Enchis12/HE-Keyboard-Trial/HE_Keyboard_Trial.kicad_pcb

## KiCad design HE_Keyboard_Trial.kicad_pcb (2025-02-14)

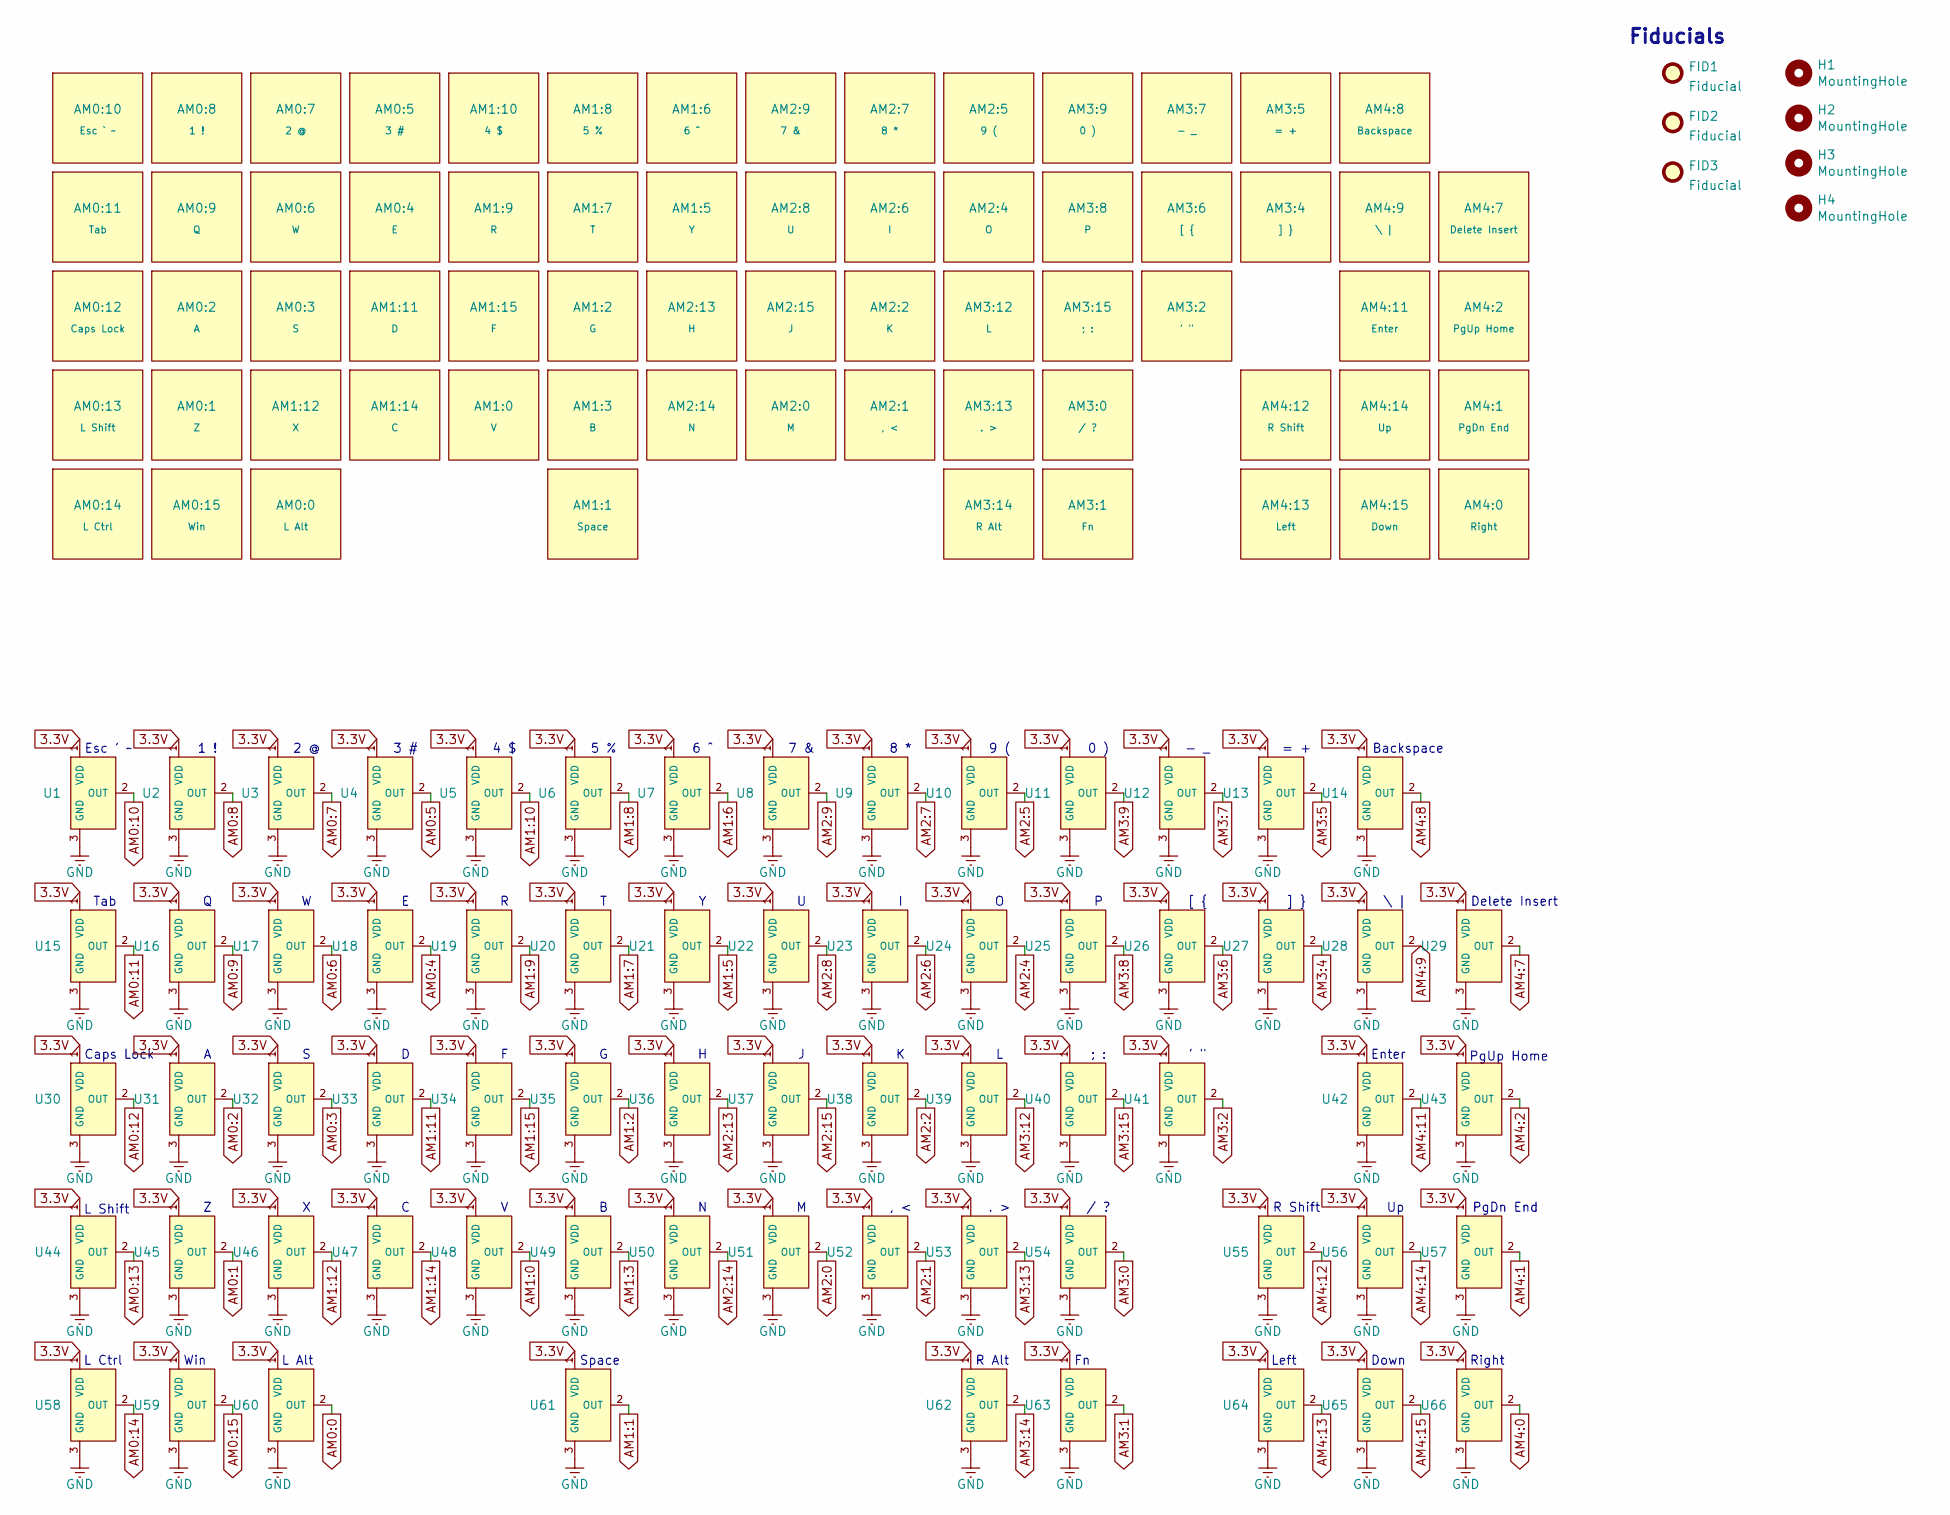
[picture p1: schematic sensor.kicad_sch, Switch, Hall Sensor, and Mounting Hole]

Parts:
AM0:0: L Alt; MX_Gateron_HE_1.25u
AM0:1: Z; MX_Gateron_HE_1u
AM0:2: A; MX_Gateron_HE_1u
AM0:3: S; MX_Gateron_HE_1u
AM0:4: E; MX_Gateron_HE_1u
AM0:5: 3 #; MX_Gateron_HE_1u
AM0:6: W; MX_Gateron_HE_1u
AM0:7: 2 @; MX_Gateron_HE_1u
AM0:8: 1 !; MX_Gateron_HE_1u
AM0:9: Q; MX_Gateron_HE_1u
AM0:10: Esc ` ~; MX_Gateron_HE_1u
AM0:11: Tab; MX_Gateron_HE_1.5u
AM0:12: Caps Lock; MX_Gateron_HE_1.75u
AM0:13: L Shift; MX_Gateron_HE_2.25u_Stab
AM0:14: L Ctrl; MX_Gateron_HE_1.25u
AM0:15: Win; MX_Gateron_HE_1.25u
AM1:0: V; MX_Gateron_HE_1u
AM1:1: Space; MX_Gateron_HE_6.25u_Stab
AM1:2: G; MX_Gateron_HE_1u
AM1:3: B; MX_Gateron_HE_1u
AM1:5: Y; MX_Gateron_HE_1u
AM1:6: 6 ^; MX_Gateron_HE_1u
AM1:7: T; MX_Gateron_HE_1u
AM1:8: 5 %; MX_Gateron_HE_1u
AM1:9: R; MX_Gateron_HE_1u
AM1:10: 4 $; MX_Gateron_HE_1u
AM1:11: D; MX_Gateron_HE_1u
AM1:12: X; MX_Gateron_HE_1u
AM1:14: C; MX_Gateron_HE_1u
AM1:15: F; MX_Gateron_HE_1u
AM2:0: M; MX_Gateron_HE_1u
AM2:1: , <; MX_Gateron_HE_1u
AM2:2: K; MX_Gateron_HE_1u
AM2:4: O; MX_Gateron_HE_1u
AM2:5: 9 (; MX_Gateron_HE_1u
AM2:6: I; MX_Gateron_HE_1u
AM2:7: 8 *; MX_Gateron_HE_1u
AM2:8: U; MX_Gateron_HE_1u
AM2:9: 7 &; MX_Gateron_HE_1u
AM2:13: H; MX_Gateron_HE_1u
AM2:14: N; MX_Gateron_HE_1u
AM2:15: J; MX_Gateron_HE_1u
AM3:0: / ?; MX_Gateron_HE_1u
AM3:1: Fn; MX_Gateron_HE_1.25u
AM3:2: ' "; MX_Gateron_HE_1u
AM3:4: ] }; MX_Gateron_HE_1u
AM3:5: = +; MX_Gateron_HE_1u
AM3:6: [ {; MX_Gateron_HE_1u
AM3:7: - _; MX_Gateron_HE_1u
AM3:8: P; MX_Gateron_HE_1u
AM3:9: 0 ); MX_Gateron_HE_1u
AM3:12: L; MX_Gateron_HE_1u
AM3:13: . >; MX_Gateron_HE_1u
AM3:14: R Alt; MX_Gateron_HE_1.25u
AM3:15: ; :; MX_Gateron_HE_1u
AM4:0: Right; MX_Gateron_HE_1u
AM4:1: PgDn End; MX_Gateron_HE_1u
AM4:2: PgUp Home; MX_Gateron_HE_1u
AM4:7: Delete Insert; MX_Gateron_HE_1u
AM4:8: Backspace; MX_Gateron_HE_2u_Stab
AM4:9: \ |; MX_Gateron_HE_1.5u
AM4:11: Enter; MX_Gateron_HE_2.25u_Stab
AM4:12: R Shift; MX_Gateron_HE_1.75u
AM4:13: Left; MX_Gateron_HE_1u
AM4:14: Up; MX_Gateron_HE_1u
AM4:15: Down; MX_Gateron_HE_1u
FID1, FID2, FID3: Fiducial; Fiducial_1mm_Mask2mm
H1, H2, H3, H4: MountingHole; MountingHole_2.2mm_M2
U1, U2, U3, U4, U5, U6, U7, U8, U9, U10, U11, U12, U13, U14, U15, U16, U17, U18, U19, U20, U21, U22, U23, U24, U25, U26, U27, U28, U29, U30, U31, U32, U33, U34, U35, U36, U37, U38, U39, U40, U41, U42, U43, U44, U45, U46, U47, U48, U49, U50, U51, U52, U53, U54, U55, U56, U57, U58, U59, U60, U61, U62, U63, U64, U65, U66: Hall_Sensor; GH39FKSW_OH49E-S; MPN GH39FKSW; LCSC Part C266230

Connections:
3.3V: U1.1 (VDD), U2.1 (VDD), U3.1 (VDD), U4.1 (VDD), U5.1 (VDD), U6.1 (VDD), U7.1 (VDD), U8.1 (VDD), U9.1 (VDD), U10.1 (VDD), U11.1 (VDD), U12.1 (VDD), U13.1 (VDD), U14.1 (VDD), U15.1 (VDD), U16.1 (VDD), U17.1 (VDD), U18.1 (VDD), U19.1 (VDD), U20.1 (VDD), U21.1 (VDD), U22.1 (VDD), U23.1 (VDD), U24.1 (VDD), U25.1 (VDD), U26.1 (VDD), U27.1 (VDD), U28.1 (VDD), U29.1 (VDD), U30.1 (VDD), U31.1 (VDD), U32.1 (VDD), U33.1 (VDD), U34.1 (VDD), U35.1 (VDD), U36.1 (VDD), U37.1 (VDD), U38.1 (VDD), U39.1 (VDD), U40.1 (VDD), U41.1 (VDD), U42.1 (VDD), U43.1 (VDD), U44.1 (VDD), U45.1 (VDD), U46.1 (VDD), U47.1 (VDD), U48.1 (VDD), U49.1 (VDD), U50.1 (VDD), U51.1 (VDD), U52.1 (VDD), U53.1 (VDD), U54.1 (VDD), U55.1 (VDD), U56.1 (VDD), U57.1 (VDD), U58.1 (VDD), U59.1 (VDD), U60.1 (VDD), U61.1 (VDD), U62.1 (VDD), U63.1 (VDD), U64.1 (VDD), U65.1 (VDD), U66.1 (VDD); also elsewhere on the board
AM0:0: U60.2 (OUT); also elsewhere on the board
AM0:1: U45.2 (OUT); also elsewhere on the board
AM0:2: U31.2 (OUT); also elsewhere on the board
AM0:3: U32.2 (OUT); also elsewhere on the board
AM0:4: U18.2 (OUT); also elsewhere on the board
AM0:5: U4.2 (OUT); also elsewhere on the board
AM0:6: U17.2 (OUT); also elsewhere on the board
AM0:7: U3.2 (OUT); also elsewhere on the board
AM0:8: U2.2 (OUT); also elsewhere on the board
AM0:9: U16.2 (OUT); also elsewhere on the board
AM0:10: U1.2 (OUT); also elsewhere on the board
AM0:11: U15.2 (OUT); also elsewhere on the board
AM0:12: U30.2 (OUT); also elsewhere on the board
AM0:13: U44.2 (OUT); also elsewhere on the board
AM0:14: U58.2 (OUT); also elsewhere on the board
AM0:15: U59.2 (OUT); also elsewhere on the board
AM1:0: U48.2 (OUT); also elsewhere on the board
AM1:1: U61.2 (OUT); also elsewhere on the board
AM1:2: U35.2 (OUT); also elsewhere on the board
AM1:3: U49.2 (OUT); also elsewhere on the board
AM1:5: U21.2 (OUT); also elsewhere on the board
AM1:6: U7.2 (OUT); also elsewhere on the board
AM1:7: U20.2 (OUT); also elsewhere on the board
AM1:8: U6.2 (OUT); also elsewhere on the board
AM1:9: U19.2 (OUT); also elsewhere on the board
AM1:10: U5.2 (OUT); also elsewhere on the board
AM1:11: U33.2 (OUT); also elsewhere on the board
AM1:12: U46.2 (OUT); also elsewhere on the board
AM1:14: U47.2 (OUT); also elsewhere on the board
AM1:15: U34.2 (OUT); also elsewhere on the board
AM2:0: U51.2 (OUT); also elsewhere on the board
AM2:1: U52.2 (OUT); also elsewhere on the board
AM2:2: U38.2 (OUT); also elsewhere on the board
AM2:4: U24.2 (OUT); also elsewhere on the board
AM2:5: U10.2 (OUT); also elsewhere on the board
AM2:6: U23.2 (OUT); also elsewhere on the board
AM2:7: U9.2 (OUT); also elsewhere on the board
AM2:8: U22.2 (OUT); also elsewhere on the board
AM2:9: U8.2 (OUT); also elsewhere on the board
AM2:13: U36.2 (OUT); also elsewhere on the board
AM2:14: U50.2 (OUT); also elsewhere on the board
AM2:15: U37.2 (OUT); also elsewhere on the board
AM3:0: U54.2 (OUT); also elsewhere on the board
AM3:1: U63.2 (OUT); also elsewhere on the board
AM3:2: U41.2 (OUT); also elsewhere on the board
AM3:4: U27.2 (OUT); also elsewhere on the board
AM3:5: U13.2 (OUT); also elsewhere on the board
AM3:6: U26.2 (OUT); also elsewhere on the board
AM3:7: U12.2 (OUT); also elsewhere on the board
AM3:8: U25.2 (OUT); also elsewhere on the board
AM3:9: U11.2 (OUT); also elsewhere on the board
AM3:12: U39.2 (OUT); also elsewhere on the board
AM3:13: U53.2 (OUT); also elsewhere on the board
AM3:14: U62.2 (OUT); also elsewhere on the board
AM3:15: U40.2 (OUT); also elsewhere on the board
AM4:0: U66.2 (OUT); also elsewhere on the board
AM4:1: U57.2 (OUT); also elsewhere on the board
AM4:2: U43.2 (OUT); also elsewhere on the board
AM4:7: U29.2 (OUT); also elsewhere on the board
AM4:8: U14.2 (OUT); also elsewhere on the board
AM4:9: U28.2 (OUT); also elsewhere on the board
AM4:11: U42.2 (OUT); also elsewhere on the board
AM4:12: U55.2 (OUT); also elsewhere on the board
AM4:13: U64.2 (OUT); also elsewhere on the board
AM4:14: U56.2 (OUT); also elsewhere on the board
AM4:15: U65.2 (OUT); also elsewhere on the board
GND: U1.3 (GND), U2.3 (GND), U3.3 (GND), U4.3 (GND), U5.3 (GND), U6.3 (GND), U7.3 (GND), U8.3 (GND), U9.3 (GND), U10.3 (GND), U11.3 (GND), U12.3 (GND), U13.3 (GND), U14.3 (GND), U15.3 (GND), U16.3 (GND), U17.3 (GND), U18.3 (GND), U19.3 (GND), U20.3 (GND), U21.3 (GND), U22.3 (GND), U23.3 (GND), U24.3 (GND), U25.3 (GND), U26.3 (GND), U27.3 (GND), U28.3 (GND), U29.3 (GND), U30.3 (GND), U31.3 (GND), U32.3 (GND), U33.3 (GND), U34.3 (GND), U35.3 (GND), U36.3 (GND), U37.3 (GND), U38.3 (GND), U39.3 (GND), U40.3 (GND), U41.3 (GND), U42.3 (GND), U43.3 (GND), U44.3 (GND), U45.3 (GND), U46.3 (GND), U47.3 (GND), U48.3 (GND), U49.3 (GND), U50.3 (GND), U51.3 (GND), U52.3 (GND), U53.3 (GND), U54.3 (GND), U55.3 (GND), U56.3 (GND), U57.3 (GND), U58.3 (GND), U59.3 (GND), U60.3 (GND), U61.3 (GND), U62.3 (GND), U63.3 (GND), U64.3 (GND), U65.3 (GND), U66.3 (GND); also elsewhere on the board

Notes on the sheet:
Fiducials
Delete Insert
PgUp Home
] }
Space
. >
Backspace
PgDn End
, <
Win
Left
5 %
Enter
\ |
4 $
Down
3 #
Right
R Shift
= +
Tab
7 &
Caps Lock
2 @
L Alt
Esc ' ~
R Alt
; :
0 )
- _
9 (
1 !
/ ?
[ {
' "
6 ^
L Ctrl
8 *
L Shift
