Enchis12/HE-Keyboard-Trial/HE_Keyboard_Trial.kicad_pcb

## KiCad design HE_Keyboard_Trial.kicad_pcb (continued)

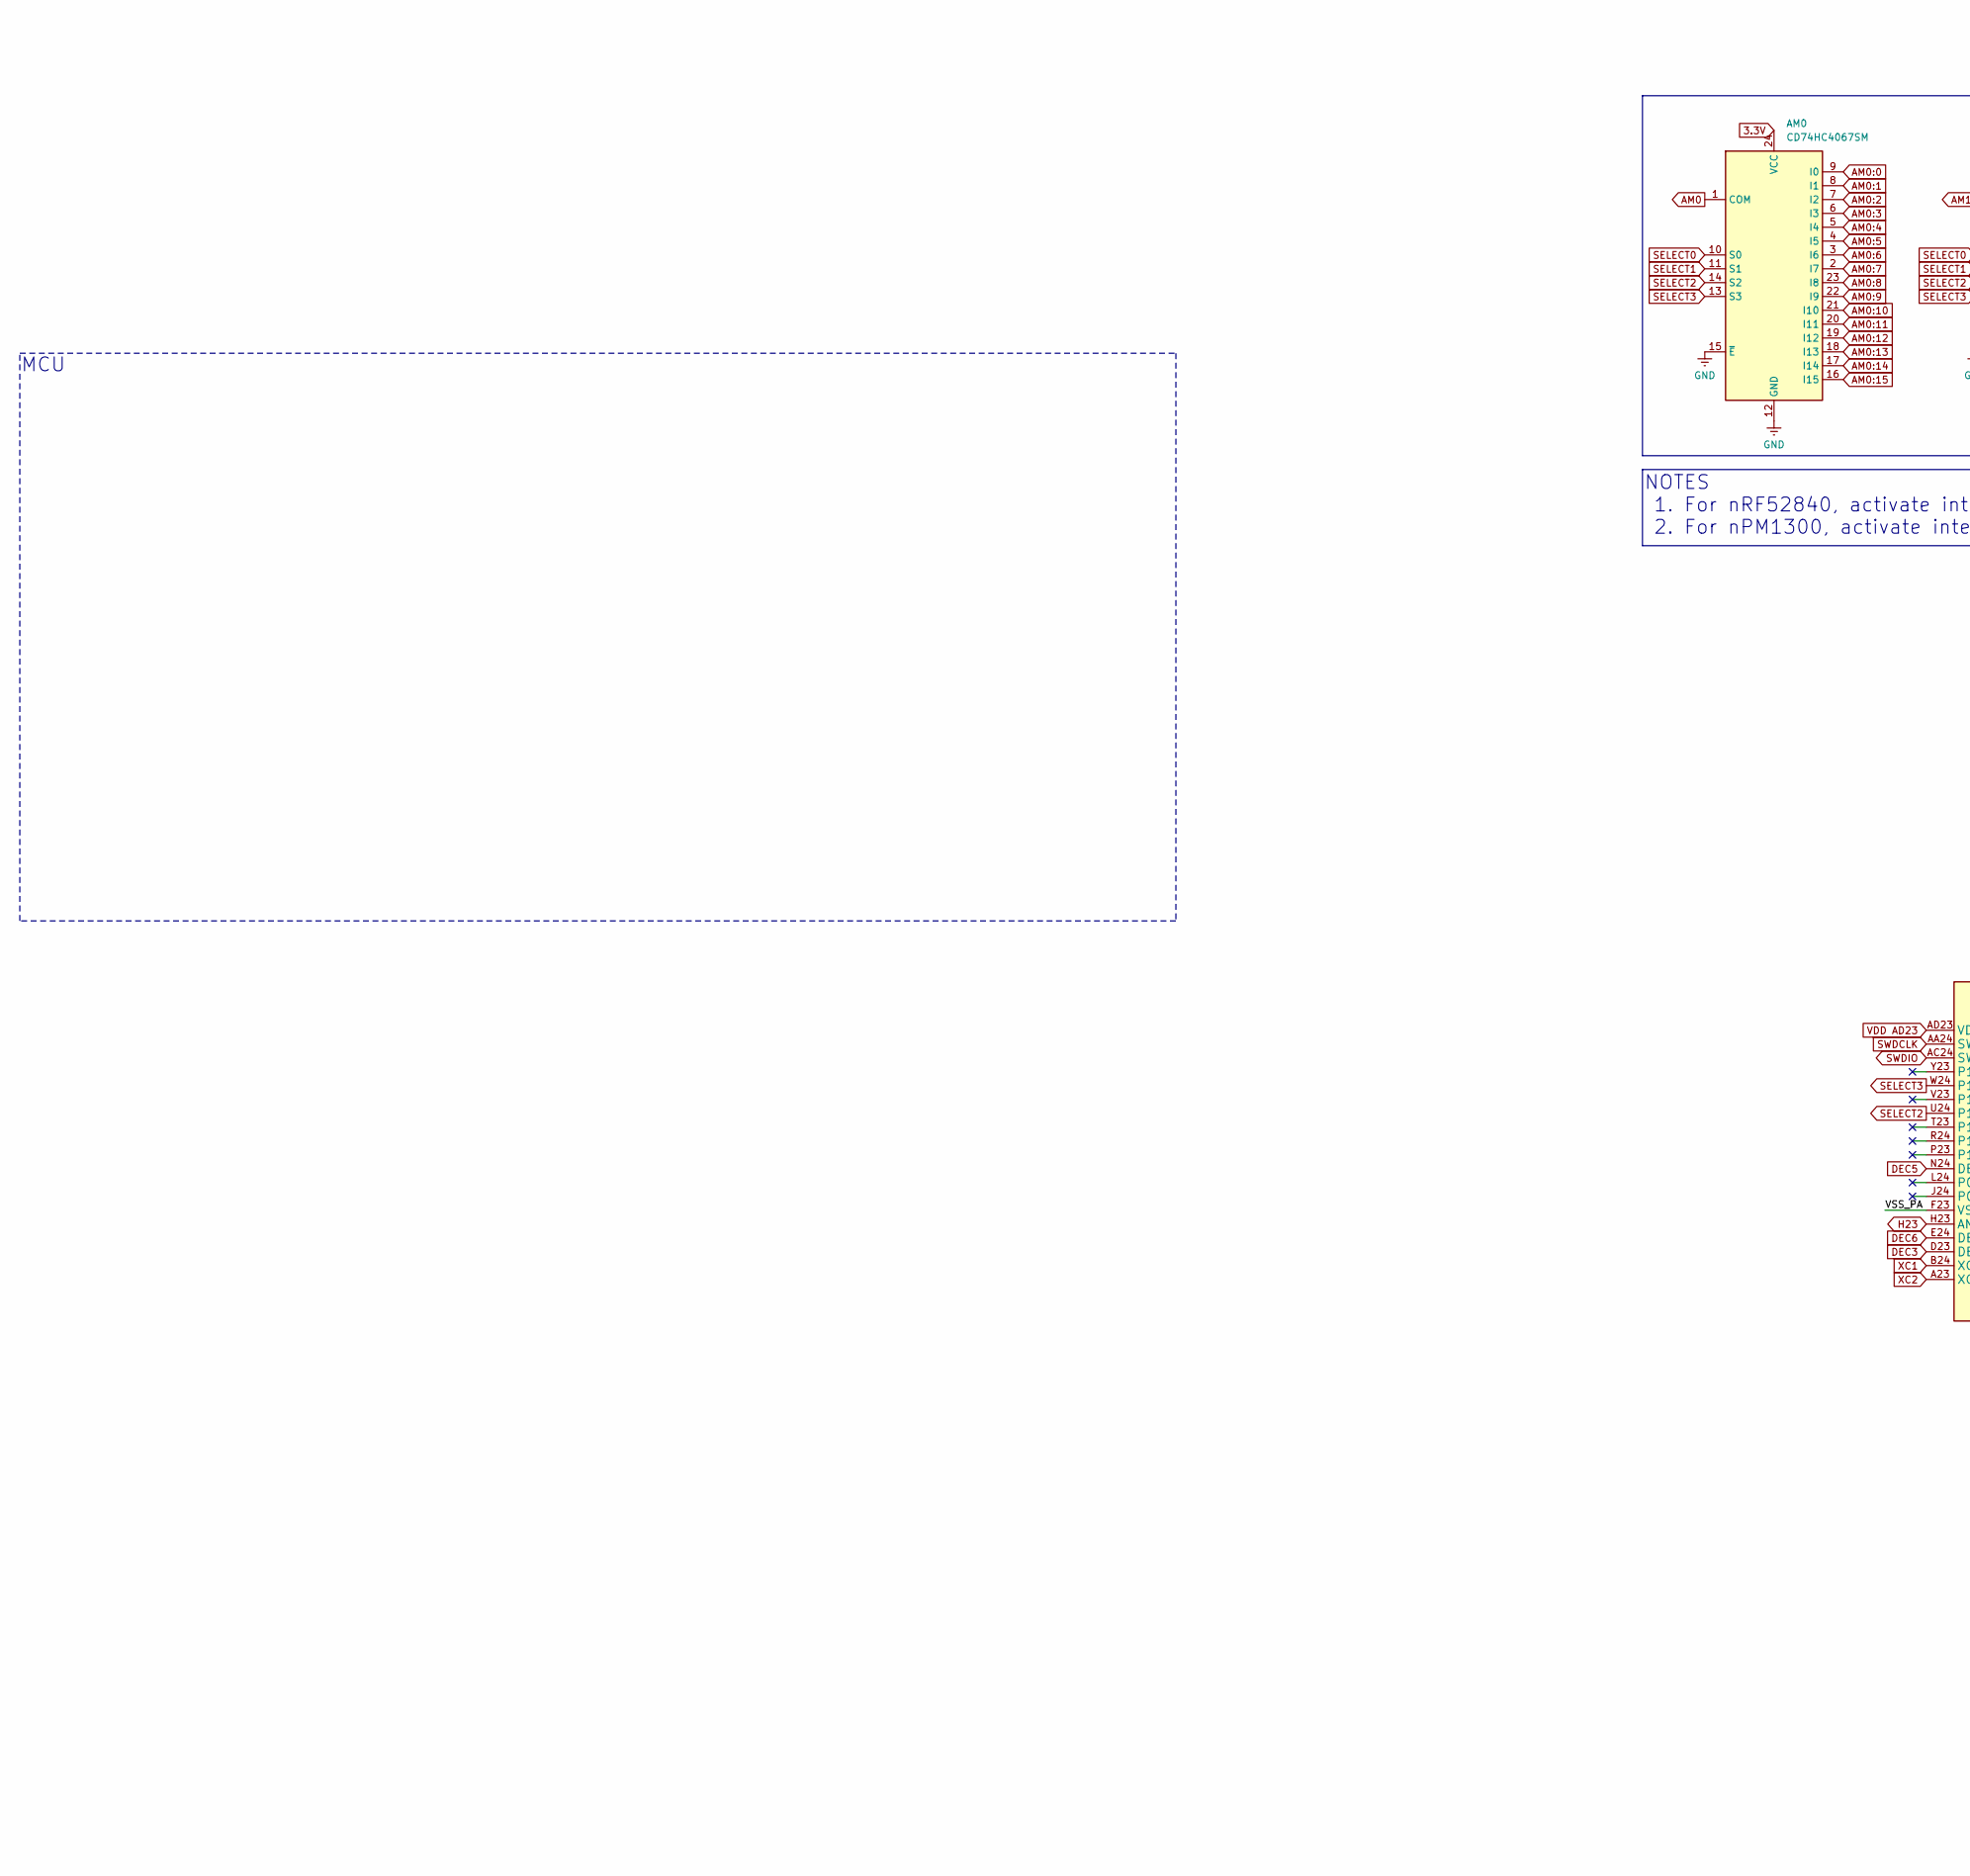
[picture p2: schematic MB.kicad_sch, Mainboard, part in row 1, column 1]

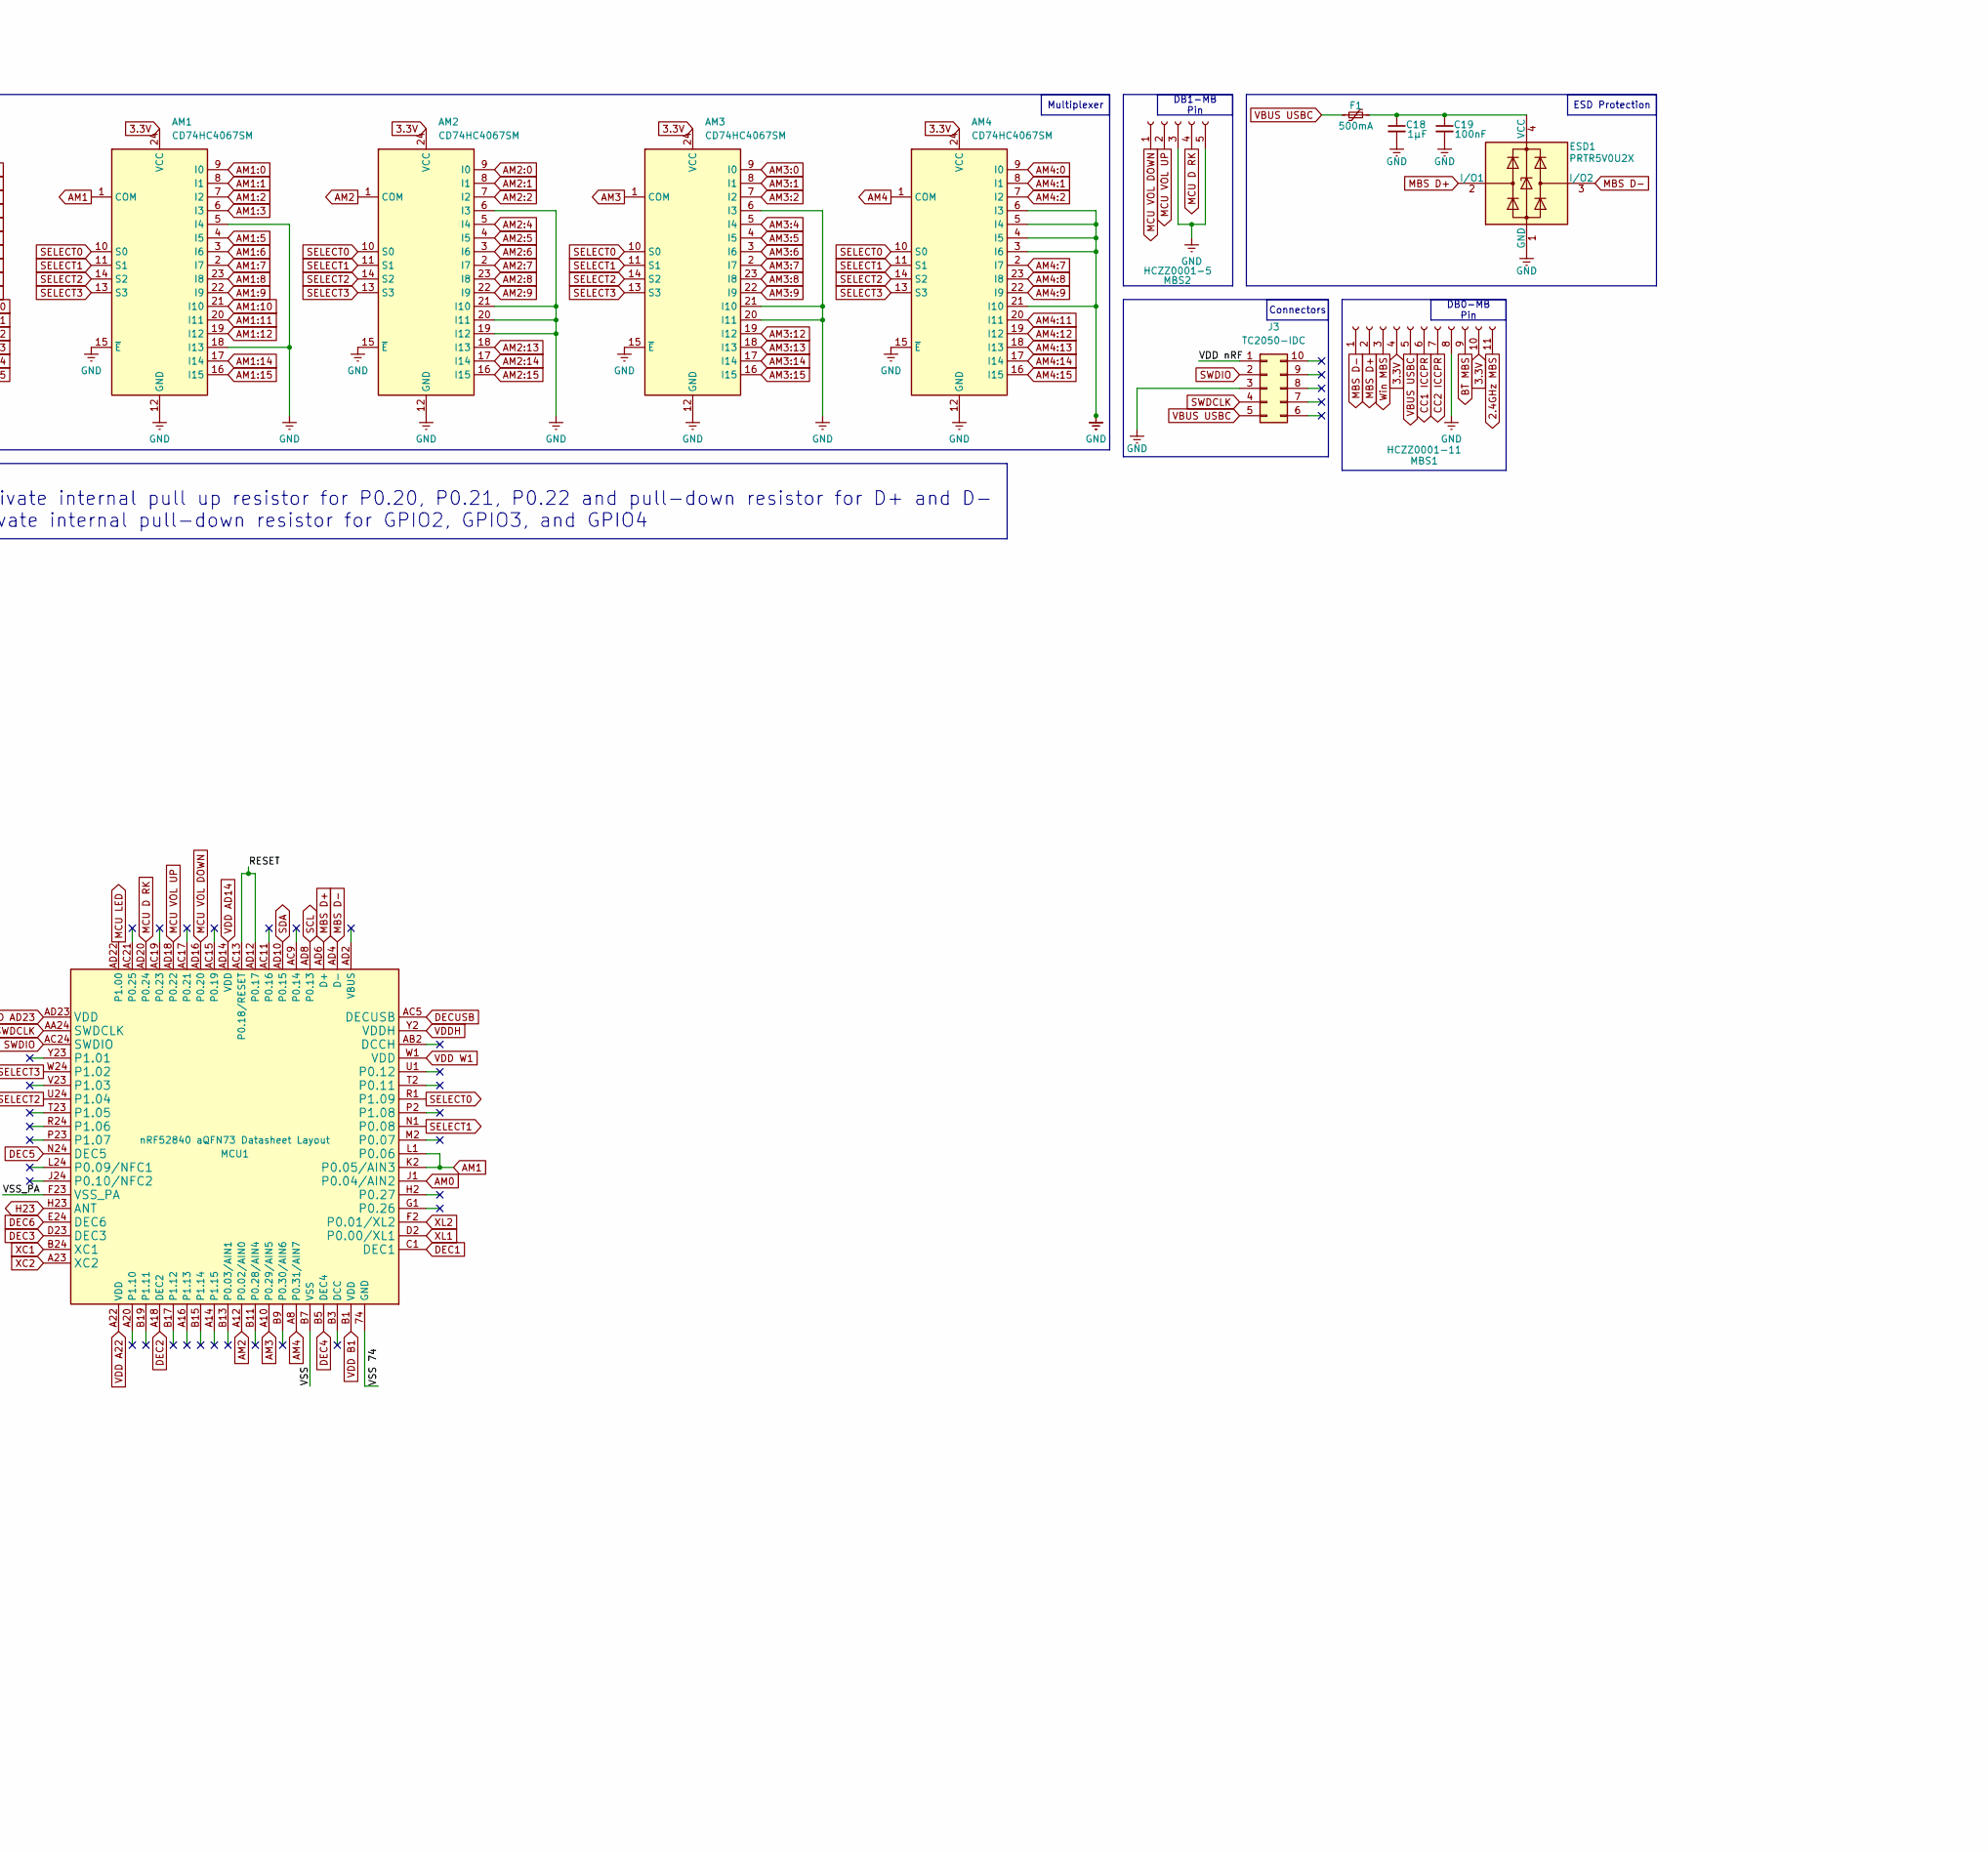
[picture p3: schematic MB.kicad_sch, Mainboard, part in row 1, column 2]

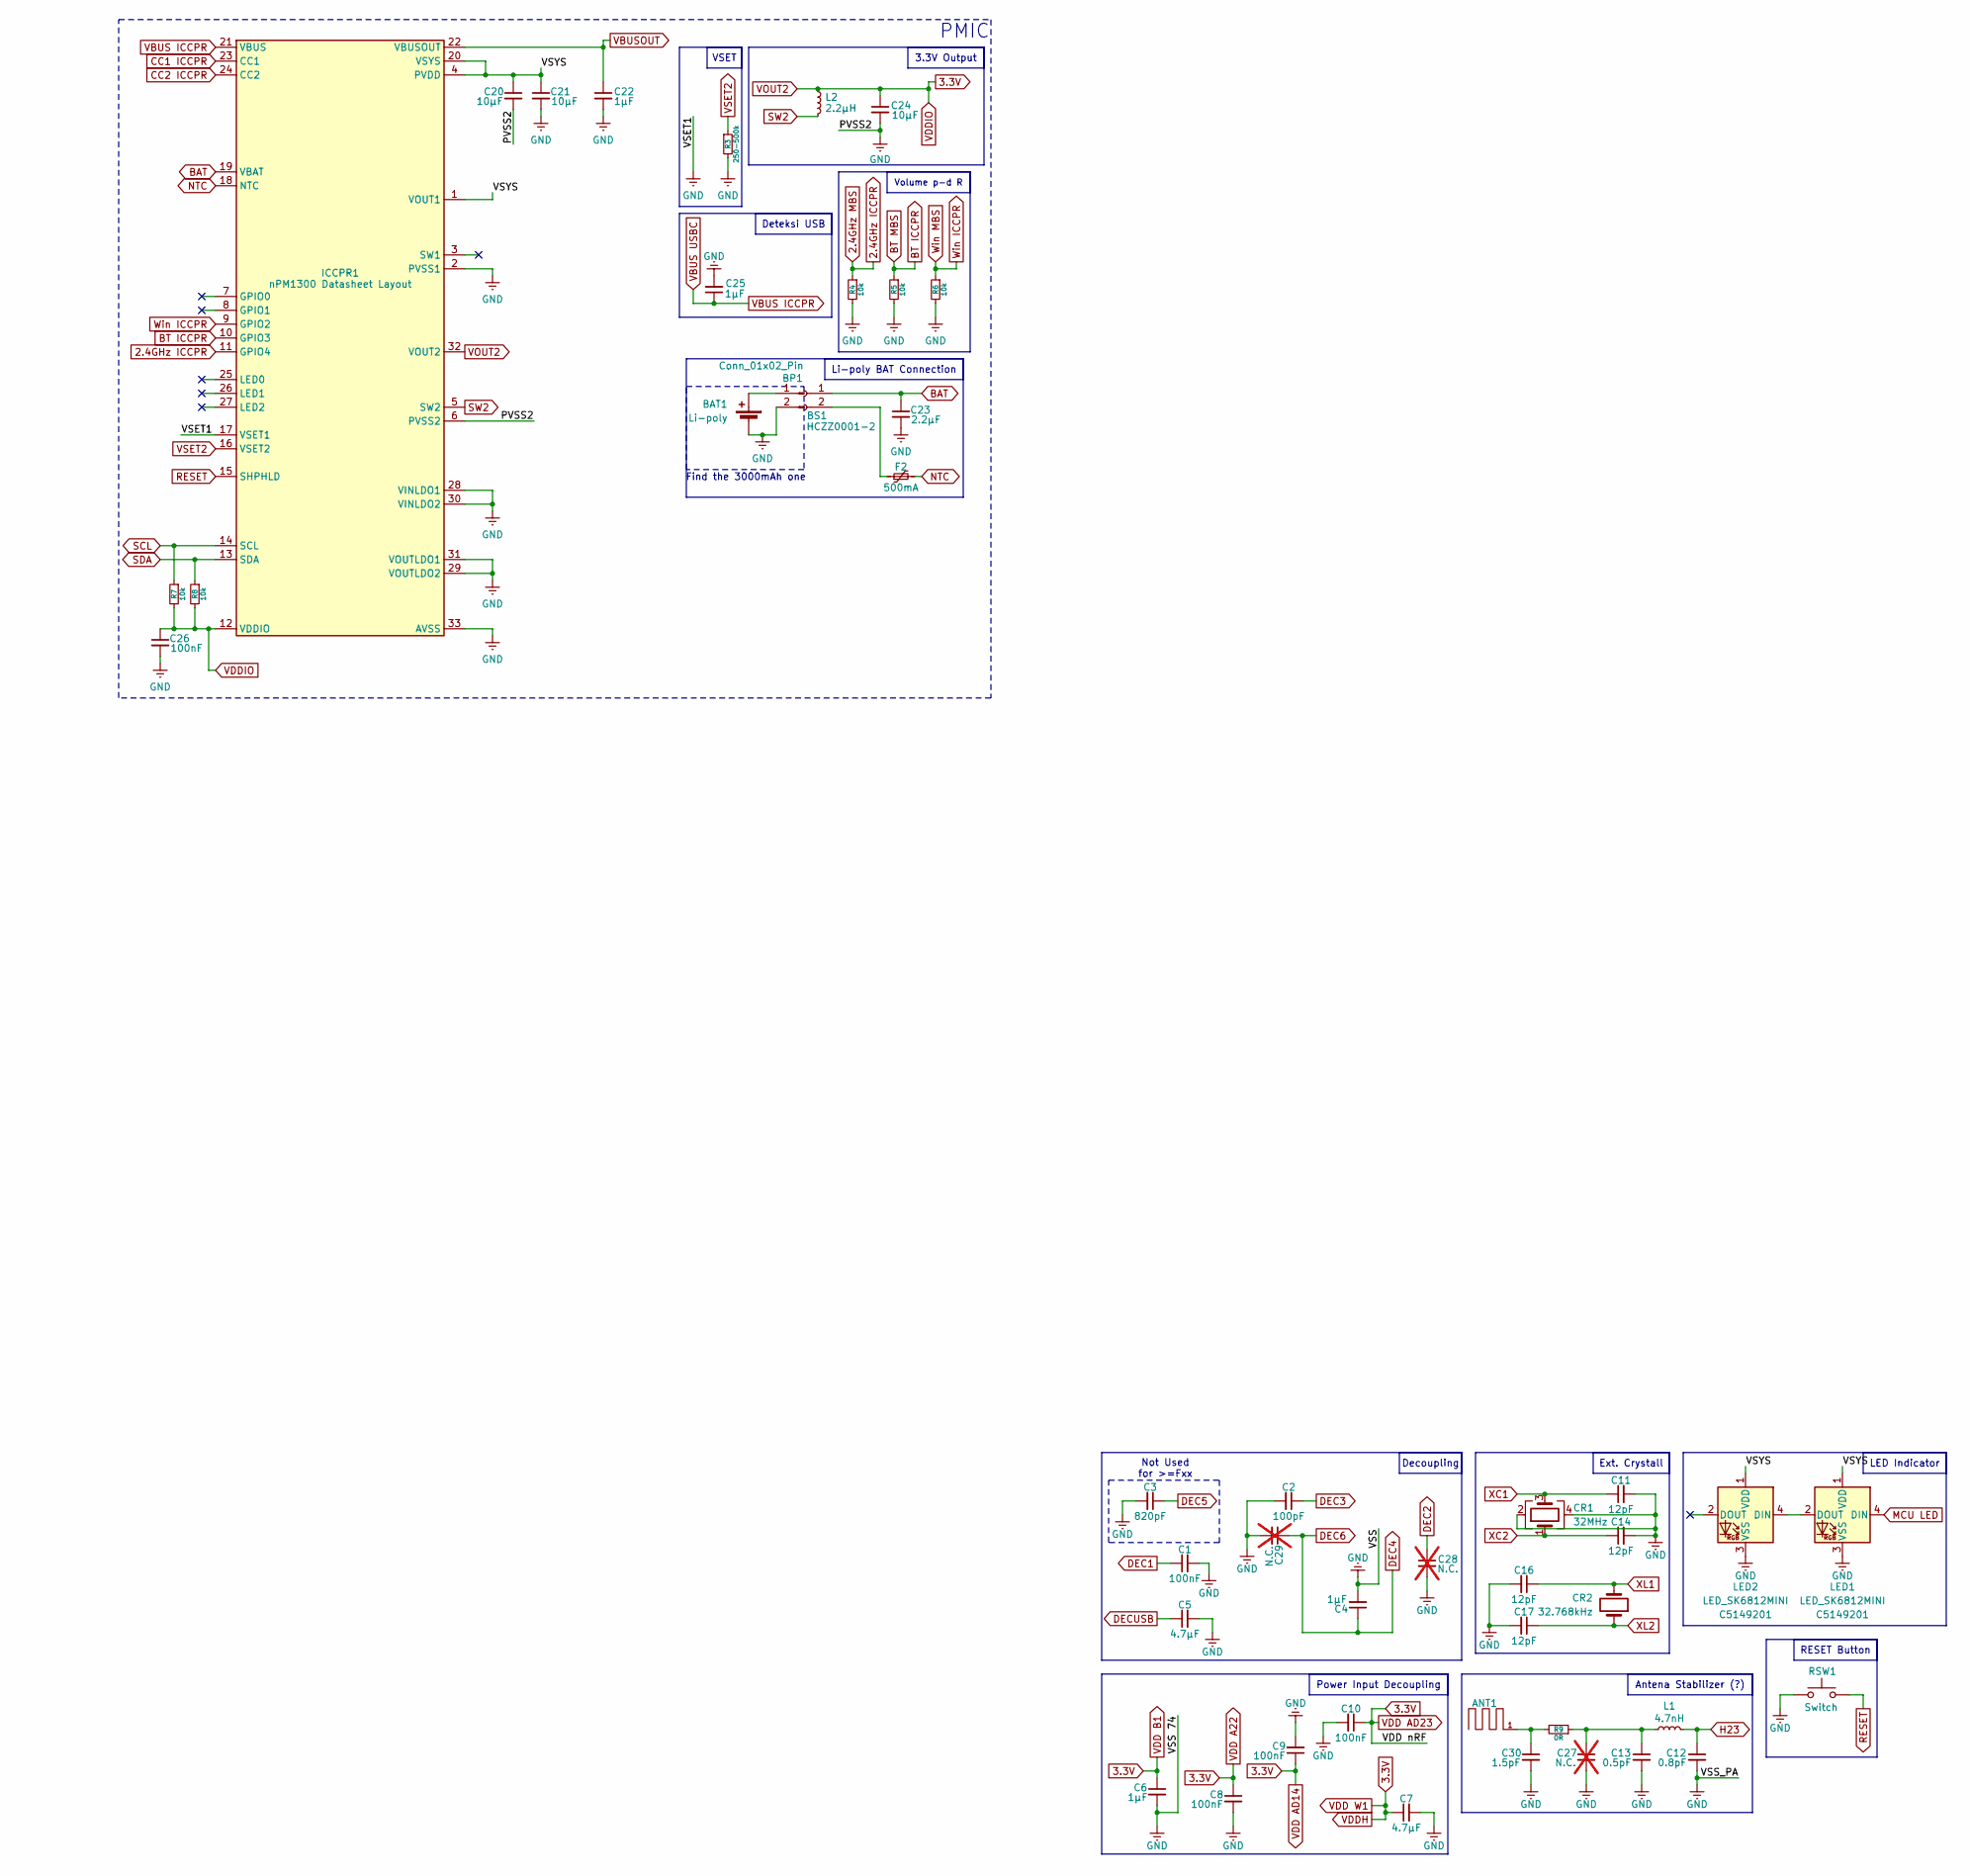
[picture p4: schematic MB.kicad_sch, Mainboard, part in row 1, column 3]

Parts:
AM0, AM1, AM2, AM3, AM4: CD74HC4067SM; SSOP-24_5.3x8.2mm_P0.65mm; LCSC Part C98457
ANT1: MIFA
BAT1: Li-poly
BP1: Conn_01x02_Pin
BS1: HCZZ0001-2; Hong_Cheng_HCZZ0001-2; LCSC Part C7433453
C1, C8, C9, C10, C19: 100nF; Capacitor_0402
C2: 100pF; Capacitor_0402
C3: 820pF; Capacitor_0402
C4, C6, C22, C25: 1µF; Capacitor_0603
C5, C7: 4.7µF; Capacitor_0603
C11, C14, C16, C17: 12pF; Capacitor_0402
C12: 0.8pF; Capacitor_0402
C13: 0.5pF; Capacitor_0402
C18: 1µF; Capacitor_0402
C20, C21, C24: 10µF; Capacitor_0603
C23: 2.2µF; Capacitor_0603
C26: 100nF; C_0201_0603Metric
C27, C28, C29: N.C.; Capacitor_0402; not fitted
C30: 1.5pF; Capacitor_0402
CR1: 32MHz; Murata_Crystal_SMD_2016-4Pin_2.0x1.6mm; LCSC Part C914155
CR2: 32.768kHz; Crystal_SMD_3215-2Pin_3.2x1.5mm; LCSC Part C97605
ESD1: PRTR5V0U2X; SOT-143; LCSC Part C41409257
F1, F2: 500mA; Fuse_1206_3216Metric; LCSC Part C269112
ICCPR1: nPM1300 Datasheet Layout; Nordic_QFN-32-1EP_5x5mm_P0.5mm_EP3.6x3.6mm_ThermalVias; LCSC Part C7501206
J3: TC2050-IDC; Tag-Connect_TC2050-IDC-NL_2x05_P1.27mm_Vertical
L1: 4.7nH; L_0402_1005Metric; LCSC Part C3249625
L2: 2.2µH; Samsung_CIGT201610EH2R2MNE; LCSC Part C5185544
LED1, LED2: LED_SK6812MINI; LCSC C5149201
MBS1: HCZZ0001-11; Hong_Cheng_HCZZ0001-11; LCSC Part C7433462
MBS2: HCZZ0001-5; Hong_Cheng_HCZZ0001-5; LCSC Part C7433456
MCU1: nRF52840 aQFN73 Datasheet Layout; Nordic_AQFN-73-1EP_7x7mm_P0.5mm_Thermal
R3: 250-500k; R_0201_0603Metric
R4, R5, R6, R7, R8: 10k; R_0201_0603Metric
R9: 0R; R_0201_0603Metric
RSW1: Switch; Button_TL3342; LCSC Part C2886897

Connections:
2.4GHz ICCPR: ICCPR1.11 (GPIO4), MBS1.11, R4.1
3.3V: AM0.24 (VCC), AM1.24 (VCC), AM2.24 (VCC), AM3.24 (VCC), AM4.24 (VCC), C6.1, C7.1, C8.1, C9.1, C10.1, C24.1, C26.1, ICCPR1.12 (VDDIO), ICCPR1.32 (VOUT2), J3.1, L2.1, MBS1.4, MBS1.10, MCU1.A22 (VDD), MCU1.AD14 (VDD), MCU1.AD23 (VDD), MCU1.B1 (VDD), MCU1.W1 (VDD), MCU1.Y2 (VDDH), R7.2, R8.2; also elsewhere on the board
/Main Board/VSYS: C20.1, C21.1, ICCPR1.1 (VOUT1), ICCPR1.4 (PVDD), ICCPR1.20 (VSYS), LED1.1 (VDD), LED2.1 (VDD)
AM0: AM0.1 (COM), MCU1.J1 (P0.04/AIN2)
AM0:0: AM0.9 (I0); also elsewhere on the board
AM0:1: AM0.8 (I1); also elsewhere on the board
AM0:2: AM0.7 (I2); also elsewhere on the board
AM0:3: AM0.6 (I3); also elsewhere on the board
AM0:4: AM0.5 (I4); also elsewhere on the board
AM0:5: AM0.4 (I5); also elsewhere on the board
AM0:6: AM0.3 (I6); also elsewhere on the board
AM0:7: AM0.2 (I7); also elsewhere on the board
AM0:8: AM0.23 (I8); also elsewhere on the board
AM0:9: AM0.22 (I9); also elsewhere on the board
AM0:10: AM0.21 (I10); also elsewhere on the board
AM0:11: AM0.20 (I11); also elsewhere on the board
AM0:12: AM0.19 (I12); also elsewhere on the board
AM0:13: AM0.18 (I13); also elsewhere on the board
AM0:14: AM0.17 (I14); also elsewhere on the board
AM0:15: AM0.16 (I15); also elsewhere on the board
AM1: AM1.1 (COM), MCU1.K2 (P0.05/AIN3), MCU1.L1 (P0.06)
AM1:0: AM1.9 (I0); also elsewhere on the board
AM1:1: AM1.8 (I1); also elsewhere on the board
AM1:2: AM1.7 (I2); also elsewhere on the board
AM1:3: AM1.6 (I3); also elsewhere on the board
AM1:5: AM1.4 (I5); also elsewhere on the board
AM1:6: AM1.3 (I6); also elsewhere on the board
AM1:7: AM1.2 (I7); also elsewhere on the board
AM1:8: AM1.23 (I8); also elsewhere on the board
AM1:9: AM1.22 (I9); also elsewhere on the board
AM1:10: AM1.21 (I10); also elsewhere on the board
AM1:11: AM1.20 (I11); also elsewhere on the board
AM1:12: AM1.19 (I12); also elsewhere on the board
AM1:14: AM1.17 (I14); also elsewhere on the board
AM1:15: AM1.16 (I15); also elsewhere on the board
AM2: AM2.1 (COM), MCU1.A12 (P0.02/AIN0)
AM2:0: AM2.9 (I0); also elsewhere on the board
AM2:1: AM2.8 (I1); also elsewhere on the board
AM2:2: AM2.7 (I2); also elsewhere on the board
AM2:4: AM2.5 (I4); also elsewhere on the board
AM2:5: AM2.4 (I5); also elsewhere on the board
AM2:6: AM2.3 (I6); also elsewhere on the board
AM2:7: AM2.2 (I7); also elsewhere on the board
AM2:8: AM2.23 (I8); also elsewhere on the board
AM2:9: AM2.22 (I9); also elsewhere on the board
AM2:13: AM2.18 (I13); also elsewhere on the board
AM2:14: AM2.17 (I14); also elsewhere on the board
AM2:15: AM2.16 (I15); also elsewhere on the board
AM3: AM3.1 (COM), MCU1.A10 (P0.29/AIN5)
AM3:0: AM3.9 (I0); also elsewhere on the board
AM3:1: AM3.8 (I1); also elsewhere on the board
AM3:2: AM3.7 (I2); also elsewhere on the board
AM3:4: AM3.5 (I4); also elsewhere on the board
AM3:5: AM3.4 (I5); also elsewhere on the board
AM3:6: AM3.3 (I6); also elsewhere on the board
AM3:7: AM3.2 (I7); also elsewhere on the board
AM3:8: AM3.23 (I8); also elsewhere on the board
AM3:9: AM3.22 (I9); also elsewhere on the board
AM3:12: AM3.19 (I12); also elsewhere on the board
AM3:13: AM3.18 (I13); also elsewhere on the board
AM3:14: AM3.17 (I14); also elsewhere on the board
AM3:15: AM3.16 (I15); also elsewhere on the board
AM4: AM4.1 (COM), MCU1.A8 (P0.31/AIN7)
AM4:0: AM4.9 (I0); also elsewhere on the board
AM4:1: AM4.8 (I1); also elsewhere on the board
AM4:2: AM4.7 (I2); also elsewhere on the board
AM4:7: AM4.2 (I7); also elsewhere on the board
AM4:8: AM4.23 (I8); also elsewhere on the board
AM4:9: AM4.22 (I9); also elsewhere on the board
AM4:11: AM4.20 (I11); also elsewhere on the board
AM4:12: AM4.19 (I12); also elsewhere on the board
AM4:13: AM4.18 (I13); also elsewhere on the board
AM4:14: AM4.17 (I14); also elsewhere on the board
AM4:15: AM4.16 (I15); also elsewhere on the board
BAT: BS1.1, C23.1, ICCPR1.19 (VBAT)
BT ICCPR: ICCPR1.10 (GPIO3), MBS1.9, R5.1
CC1 ICCPR: ICCPR1.23 (CC1), MBS1.6
CC2 ICCPR: ICCPR1.24 (CC2), MBS1.7
DEC1: C1.1, MCU1.C1 (DEC1)
DEC2: C28.1, MCU1.A18 (DEC2)
DEC3: C2.1, MCU1.D23 (DEC3)
DEC4: C4.1, C29.1, MCU1.B5 (DEC4), MCU1.E24 (DEC6)
DEC5: C3.1, MCU1.N24 (DEC5)
DECUSB: C5.1, MCU1.AC5 (DECUSB)
GND: AM0.12 (GND), AM0.15 (~E), AM1.5 (I4), AM1.12 (GND), AM1.15 (~E), AM1.18 (I13), AM2.6 (I3), AM2.12 (GND), AM2.15 (~E), AM2.19 (I12), AM2.20 (I11), AM2.21 (I10), AM3.6 (I3), AM3.12 (GND), AM3.15 (~E), AM3.20 (I11), AM3.21 (I10), AM4.3 (I6), AM4.4 (I5), AM4.5 (I4), AM4.6 (I3), AM4.12 (GND), AM4.15 (~E), AM4.21 (I10), BAT1.2 (-), BP1.2, C1.2, C2.2, C3.2, C4.2, C5.2, C6.2, C7.2, C8.2, C9.2, C10.2, C11.2, C12.2, C13.2, C14.2, C16.2, C17.2, C18.2, C19.2, C20.2, C21.2, C22.2, C23.2, C24.2, C25.2, C26.2, C27.2, C28.2, C29.2, C30.2, CR1.2, CR1.4, ESD1.1 (GND), ICCPR1.2 (PVSS1), ICCPR1.6 (PVSS2), ICCPR1.17 (VSET1), ICCPR1.28 (VINLDO1), ICCPR1.29 (VOUTLDO2), ICCPR1.30 (VINLDO2), ICCPR1.31 (VOUTLDO1), ICCPR1.33 (AVSS), J3.3, LED1.3 (VSS), LED2.3 (VSS), MBS1.8, MBS2.3, MBS2.5, MCU1.74 (GND), MCU1.B7 (VSS), MCU1.F23 (VSS_PA), R3.2, R4.2, R5.2, R6.2, RSW1.1; also elsewhere on the board
H23: C12.1, L1.1, MCU1.H23 (ANT)
MBS D+: ESD1.2 (I/O1), MBS1.2, MCU1.AD6 (D+)
MBS D-: ESD1.3 (I/O2), MBS1.1, MCU1.AD4 (D-)
MCU D RK: MBS2.4, MCU1.AD20 (P0.24)
MCU LED: LED1.4 (DIN), MCU1.AD22 (P1.00)
MCU VOL DOWN: MBS2.1, MCU1.AD16 (P0.20)
MCU VOL UP: MBS2.2, MCU1.AD18 (P0.22)
NTC: F2.2, ICCPR1.18 (NTC)
unnamed: ANT1.1, C30.1, R9.2
unnamed: BAT1.1 (+), BP1.1
unnamed: BS1.2, F2.1
unnamed: C13.1, C27.1, L1.2, R9.1
unnamed: C18.1, C19.1, ESD1.4 (VCC), F1.2
unnamed: LED1.2 (DOUT), LED2.4 (DIN)
RESET: ICCPR1.15 (SHPHLD), MCU1.AC13 (P0.18/RESET), MCU1.AD12 (P0.17), RSW1.2
SCL: ICCPR1.14 (SCL), MCU1.AD8 (P0.13), R7.1
SDA: ICCPR1.13 (SDA), MCU1.AD10 (P0.15), R8.1
SELECT0: AM0.10 (S0), AM1.10 (S0), AM2.10 (S0), AM3.10 (S0), AM4.10 (S0), MCU1.R1 (P1.09)
SELECT1: AM0.11 (S1), AM1.11 (S1), AM2.11 (S1), AM3.11 (S1), AM4.11 (S1), MCU1.N1 (P0.08)
SELECT2: AM0.14 (S2), AM1.14 (S2), AM2.14 (S2), AM3.14 (S2), AM4.14 (S2), MCU1.U24 (P1.04)
SELECT3: AM0.13 (S3), AM1.13 (S3), AM2.13 (S3), AM3.13 (S3), AM4.13 (S3), MCU1.W24 (P1.02)
SW2: ICCPR1.5 (SW2), L2.2
SWDCLK: J3.4, MCU1.AA24 (SWDCLK)
SWDIO: J3.2, MCU1.AC24 (SWDIO)
VBUS ICCPR: C25.1, F1.1, ICCPR1.21 (VBUS), J3.5, MBS1.5; also elsewhere on the board
VBUSOUT: C22.1, ICCPR1.22 (VBUSOUT)
VSET2: ICCPR1.16 (VSET2), R3.1
Win ICCPR: ICCPR1.9 (GPIO2), MBS1.3, R6.1
XC1: C11.1, CR1.3, MCU1.B24 (XC1)
XC2: C14.1, CR1.1, MCU1.A23 (XC2)
XL1: C16.1, CR2.2, MCU1.D2 (P0.00/XL1)
XL2: C17.1, CR2.1, MCU1.F2 (P0.01/XL2)

Notes on the sheet:
Antena Stabilizer (?)
Volume p-d R
LED Indicator
DB1-MB Pin
1. For nRF52840, activate internal pull up resistor for P0.20, P0.21, P0.22 and pull-down resistor for D+ and D- 2. For nPM1300, activate internal pull-down resistor for GPIO2, GPIO3, and GPIO4
Connectors
Multiplexer
RESET Button
3.3V Output
Ext. Crystall
Li-poly BAT Connection
Decoupling
Power Input Decoupling
ESD Protection
Deteksi USB
DB0-MB Pin
VSET
MCU
Find the 3000mAh one
PMIC
Not Used for >=Fxx
NOTES

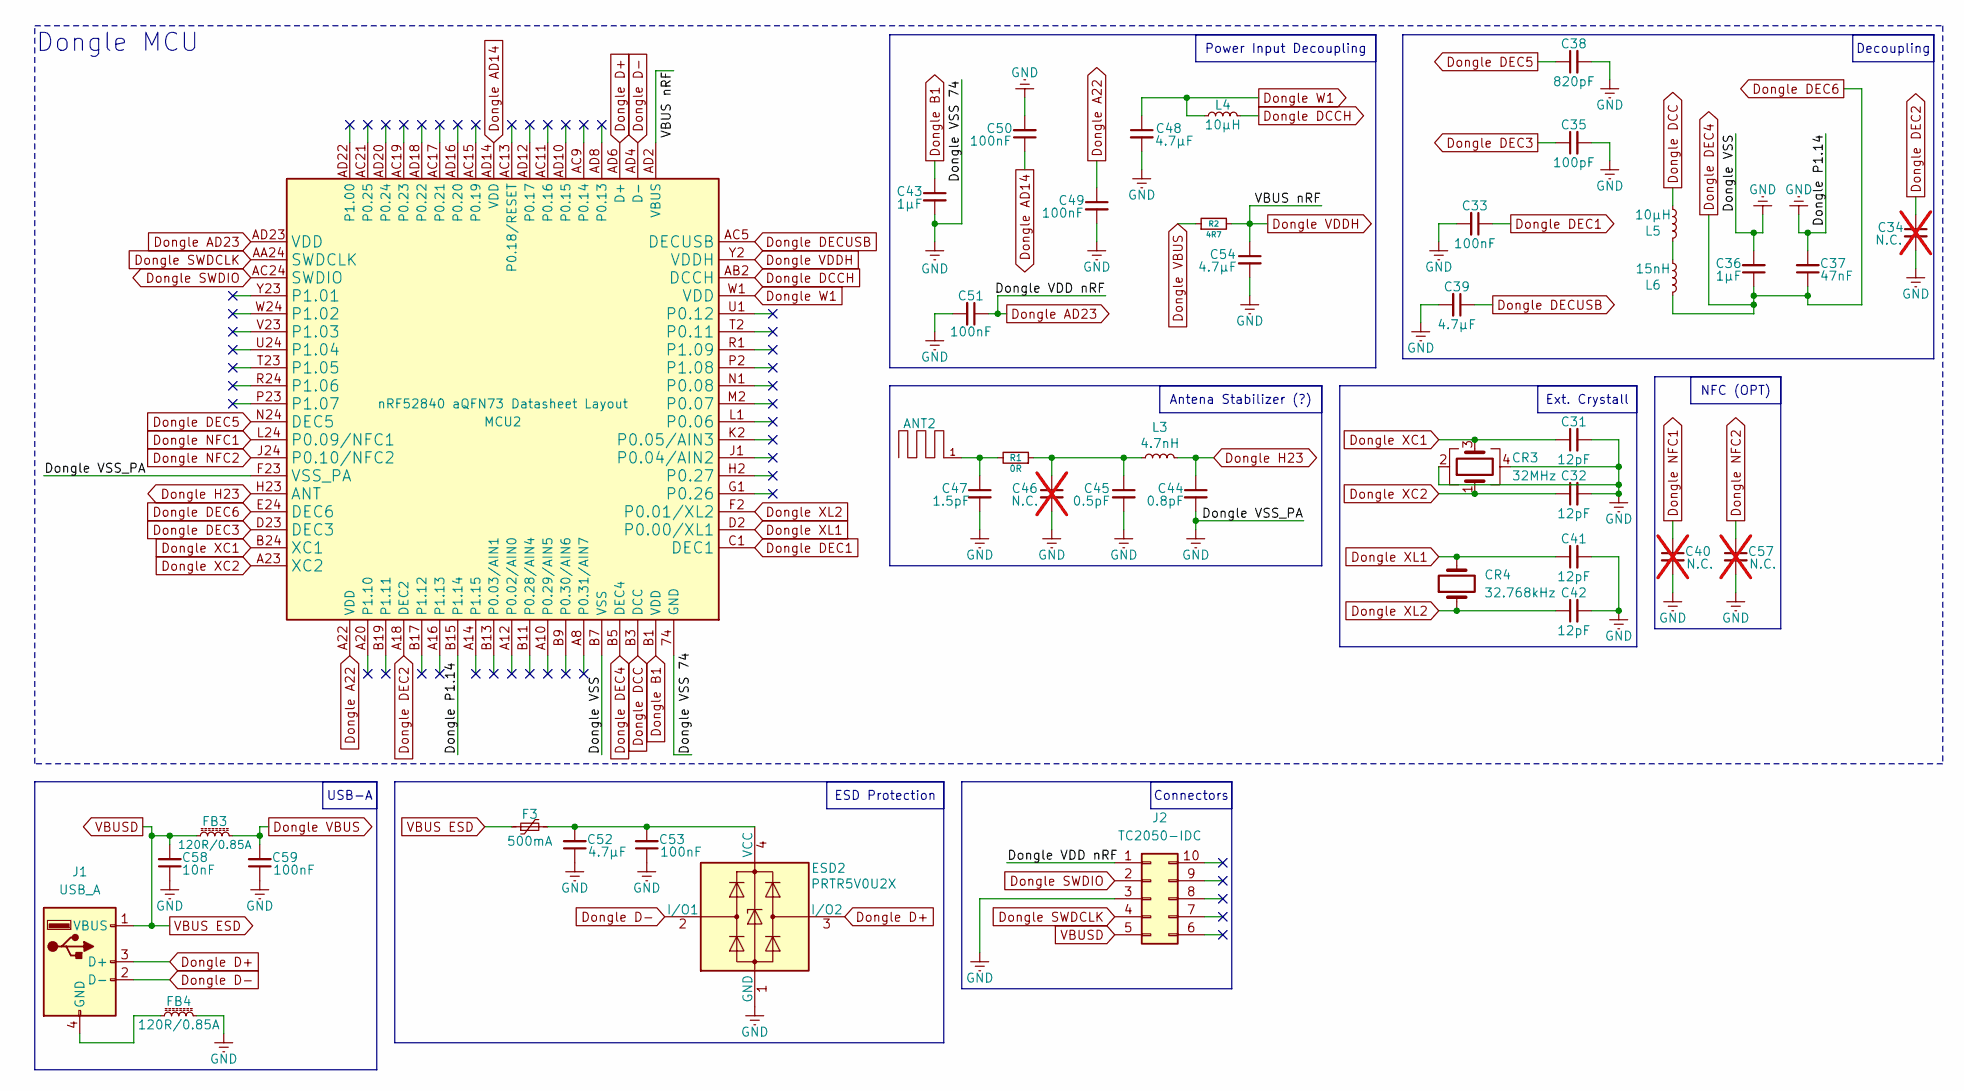
[picture p5: schematic Dongle.kicad_sch]

Parts:
ANT2: MIFA
C31, C32, C41, C42: 12pF; C_0201_0603Metric
C33, C49, C50, C51, C53, C59: 100nF; C_0201_0603Metric
C34, C40, C46, C57: N.C.; C_0201_0603Metric; not fitted
C35: 100pF; C_0201_0603Metric; LCSC Part C710791
C36, C43: 1µF; Capacitor_0603
C37: 47nF; C_0201_0603Metric
C38: 820pF; C_0201_0603Metric
C39, C48: 4.7µF; Capacitor_0603
C44: 0.8pF; C_0201_0603Metric
C45: 0.5pF; C_0201_0603Metric; LCSC Part C2981049
C47: 1.5pF; C_0201_0603Metric
C52, C54: 4.7µF; Capacitor_0402
C58: 10nF; C_0201_0603Metric
CR3: 32MHz; Murata_Crystal_SMD_2016-4Pin_2.0x1.6mm; LCSC Part C914155
CR4: 32.768kHz; Crystal_SMD_2012-2Pin_2.0x1.2mm; LCSC Part C97603
ESD2: PRTR5V0U2X; SOT-143; LCSC Part C41409257
F3: 500mA; Fuse_1206_3216Metric; LCSC Part C269112
FB3, FB4: 120R/0.85A; L_0201_0603Metric; LCSC Part C2661865
J1: USB_A; USB A
J2: TC2050-IDC; Tag-Connect_TC2050-IDC-NL_2x05_P1.27mm_Vertical
L3: 4.7nH; L_0201_0603Metric; LCSC Part C86126
L4, L5: 10µH; L_0603_1608Metric; LCSC Part C87216
L6: 15nH; L_0402_1005Metric; LCSC Part C87189
MCU2: nRF52840 aQFN73 Datasheet Layout; Nordic_AQFN-73-1EP_7x7mm_P0.5mm_Thermal
R1: 0R; R_0201_0603Metric
R2: 4R7; R_0201_0603Metric

Connections:
Dongle A22: C49.1, MCU2.A22 (VDD)
Dongle AD14: C50.1, MCU2.AD14 (VDD)
Dongle AD23: C51.1, J2.1, MCU2.AD23 (VDD)
Dongle B1: C43.1, MCU2.B1 (VDD)
Dongle D+: ESD2.3 (I/O2), J1.3 (D+), MCU2.AD6 (D+)
Dongle D-: ESD2.2 (I/O1), J1.2 (D-), MCU2.AD4 (D-)
Dongle DCC: L5.1, MCU2.B3 (DCC)
Dongle DCCH: L4.2, MCU2.AB2 (DCCH)
Dongle DEC1: C33.1, MCU2.C1 (DEC1)
Dongle DEC2: C34.1, MCU2.A18 (DEC2)
Dongle DEC3: C35.1, MCU2.D23 (DEC3)
Dongle DEC4: C36.1, C37.1, L6.2, MCU2.B5 (DEC4), MCU2.E24 (DEC6)
Dongle DEC5: C38.1, MCU2.N24 (DEC5)
Dongle DECUSB: C39.1, MCU2.AC5 (DECUSB)
Dongle H23: C44.1, L3.1, MCU2.H23 (ANT)
Dongle NFC1: C40.1, MCU2.L24 (P0.09/NFC1)
Dongle NFC2: C57.1, MCU2.J24 (P0.10/NFC2)
Dongle SWDCLK: J2.4, MCU2.AA24 (SWDCLK)
Dongle SWDIO: J2.2, MCU2.AC24 (SWDIO)
Dongle VBUS: C59.2, FB3.2, R2.1
Dongle VDDH: C54.1, MCU2.AD2 (VBUS), MCU2.Y2 (VDDH), R2.2
Dongle W1: C48.1, L4.1, MCU2.W1 (VDD)
Dongle XC1: C31.1, CR3.3, MCU2.B24 (XC1)
Dongle XC2: C32.1, CR3.1, MCU2.A23 (XC2)
Dongle XL1: C41.1, CR4.2, MCU2.D2 (P0.00/XL1)
Dongle XL2: C42.1, CR4.1, MCU2.F2 (P0.01/XL2)
GND: C31.2, C32.2, C33.2, C34.2, C35.2, C36.2, C37.2, C38.2, C39.2, C40.2, C41.2, C42.2, C43.2, C44.2, C45.2, C46.2, C47.2, C48.2, C49.2, C50.2, C51.2, C52.1, C53.1, C54.2, C57.2, C58.1, C59.1, CR3.2, CR3.4, ESD2.1 (GND), FB4.2, J2.3, MCU2.74 (GND), MCU2.B7 (VSS), MCU2.B15 (P1.14), MCU2.F23 (VSS_PA); also elsewhere on the board
unnamed: ANT2.1, C47.1, R1.2
unnamed: C45.1, C46.1, L3.2, R1.1
unnamed: C52.2, C53.2, ESD2.4 (VCC), F3.2
unnamed: FB4.1, J1.4 (GND)
unnamed: L5.2, L6.1
VBUS ESD: C58.2, F3.1, FB3.1, J1.1 (VBUS), J2.5

Notes on the sheet:
USB-A
Decoupling
NFC (OPT)
Antena Stabilizer (?)
Ext. Crystall
Power Input Decoupling
ESD Protection
Connectors
Dongle MCU

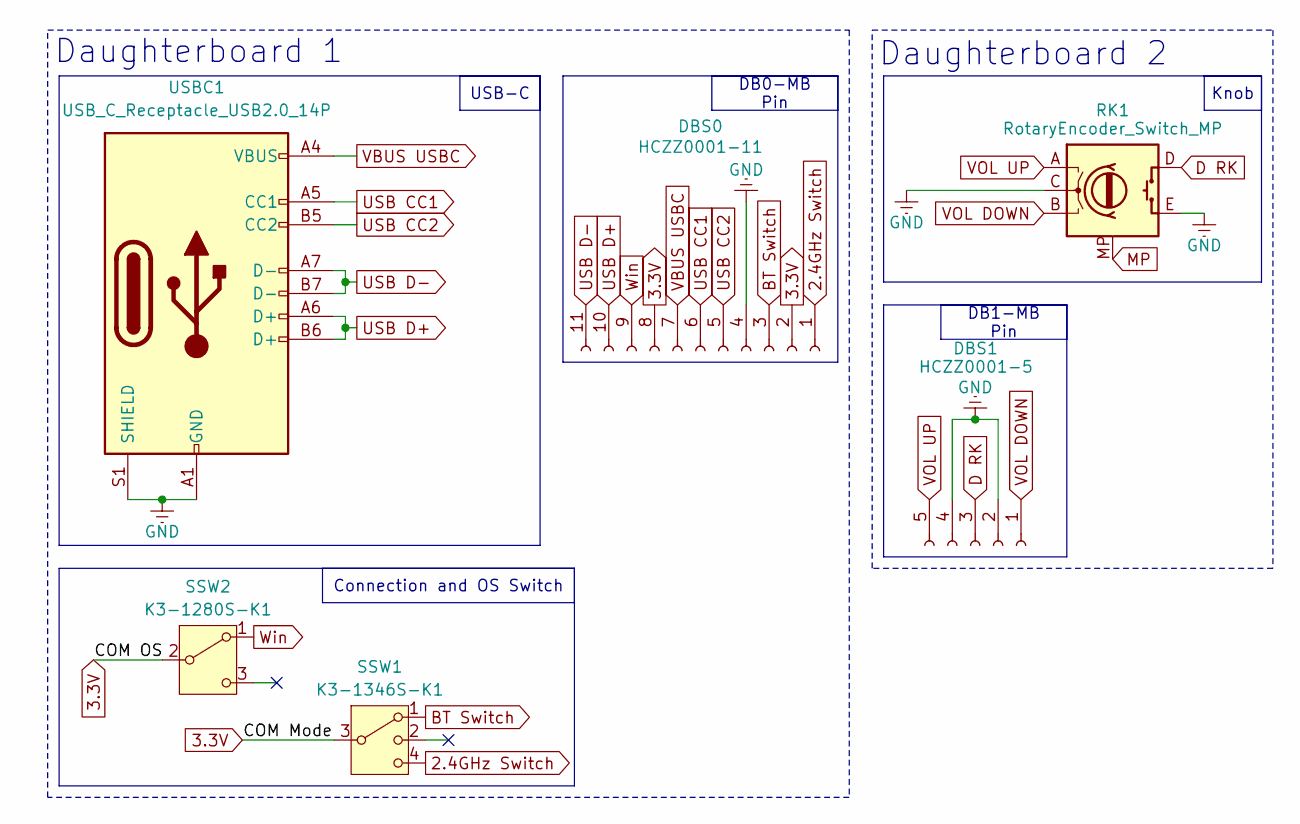
[picture p6: schematic DB.kicad_sch, Daughterboard]

Parts:
DBS0: HCZZ0001-11; Hong_Cheng_HCZZ0001-11; LCSC Part C7433462
DBS1: HCZZ0001-5; Hong_Cheng_HCZZ0001-5; LCSC Part C7433456
RK1: RotaryEncoder_Switch_MP; RotaryEncoder_CTR_ED11601M-FB15A7.0-C15-202; LCSC Part C470592
SSW1: K3-1346S-K1; SW_SP3T_Korean_Hroparts_Elec_K3-1346S-K1; LCSC Part C128957
SSW2: K3-1280S-K1; SW_SPDT_Korean_Hroparts_Elec_K3-1280S-K1; LCSC Part C128953
USBC1: USB_C_Receptacle_USB2.0_14P; USB_C_HRO_TYPE-C-31-M-12; LCSC Part C165948

Connections:
2.4GHz Switch: DBS0.1, SSW1.4
3.3V: DBS0.2, DBS0.8, SSW1.3, SSW2.2 (B); also elsewhere on the board
BT Switch: DBS0.3, SSW1.1
D RK: DBS1.3, RK1.D
GND: DBS0.4, DBS1.2, DBS1.4, RK1.C, RK1.E (S2), USBC1.A1 (GND), USBC1.A12 (GND), USBC1.B1 (GND), USBC1.B12 (GND), USBC1.S1 (SHIELD); also elsewhere on the board
MP: RK1.MP
USB CC1: DBS0.6, USBC1.A5 (CC1)
USB CC2: DBS0.5, USBC1.B5 (CC2)
USB D+: DBS0.10, USBC1.A6 (D+), USBC1.B6 (D+)
USB D-: DBS0.11, USBC1.A7 (D-), USBC1.B7 (D-)
VBUS ICCPR: DBS0.7, USBC1.A4 (VBUS), USBC1.A9 (VBUS), USBC1.B4 (VBUS), USBC1.B9 (VBUS); also elsewhere on the board
VOL DOWN: DBS1.1, RK1.B
VOL UP: DBS1.5, RK1.A
Win: DBS0.9, SSW2.1 (A)

Notes on the sheet:
Knob
Connection and OS Switch
DB1-MB Pin
DB0-MB Pin
USB-C
Daughterboard 2
Daughterboard 1
