Enchis12/HE-Keyboard-Trial/HE_Keyboard_Trial.kicad_pcb

## KiCad design HE_Keyboard_Trial.kicad_pcb (continued)

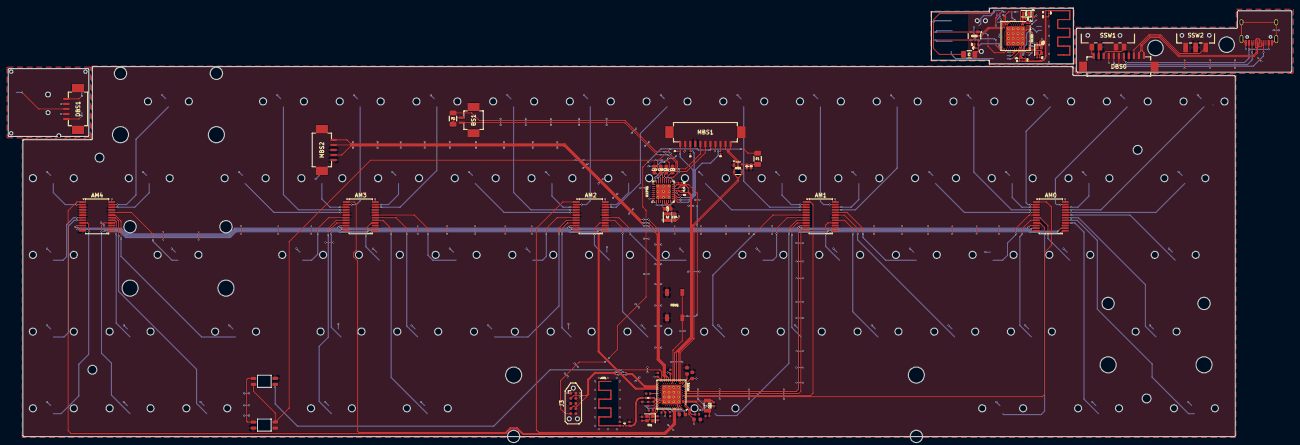
[picture p7: board HE_Keyboard_Trial.kicad_pcb from above]

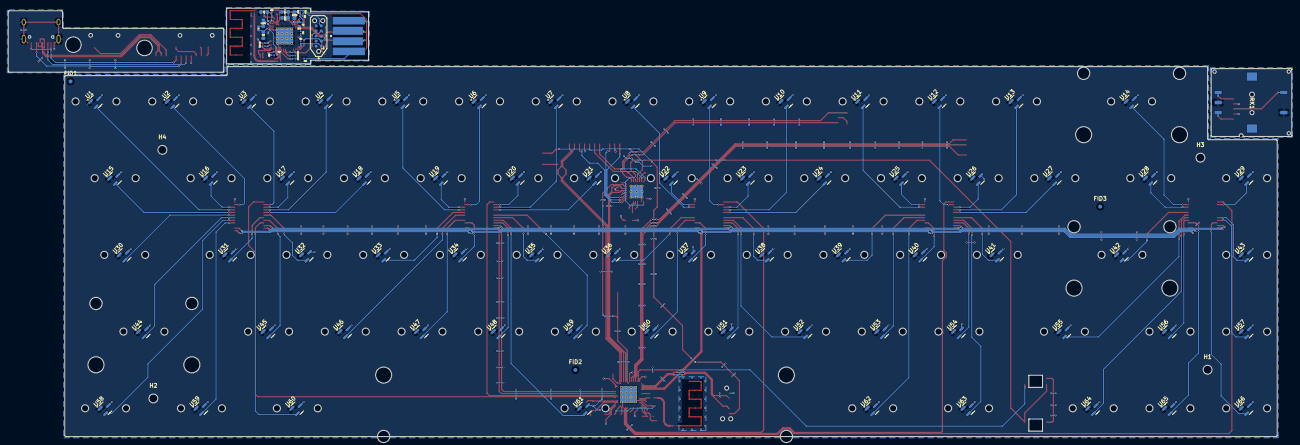
[picture p8: board HE_Keyboard_Trial.kicad_pcb from below]

Board: 2 copper layers, 318.7 x 106.4 mm, 246 parts (165 on the bottom side), 158 nets.
