Enchis12/HE-Keyboard-Trial/(commit log)

2024-12-25 Second Commit
    new wiring and label
    [DB.kicad_sch, GMK67-HE_Trial.kicad_pcb, MB.kicad_sch, sensor.kicad_sch]
2024-12-28 Third Commit
    Kinda add some little changes but still confused on how using the nPM1300
    [DB.kicad_sch, GMK67-HE_Trial.kicad_pcb, MB.kicad_sch]
2024-12-28 Fourth Commit
    changing some name to not get sued :v
    [DB.kicad_sch, HE_Keyboard_Trial.kicad_pcb, HE_Keyboard_Trial.kicad_sch, MB.kicad_sch]
2024-12-31 Fifth Commit
    updating track width and via's diameter
    [DB.kicad_sch, HE_Keyboard_Trial.kicad_pcb, HE_Keyboard_Trial.kicad_sch, MB.kicad_sch, sensor.kicad_sch]
2025-01-08 Sixth Commit
    Almost done. Just need to make sure the field zone and each pin is connected properly
    [DB.kicad_sch, HE_Keyboard_Trial.kicad_pcb, HE_Keyboard_Trial.kicad_sch, MB.kicad_sch, sensor.kicad_sch]
2025-01-18 7th Commit
    Adding the reduced nRF52840 dongle and some minor tweak
    [DB.kicad_sch, Dongle.kicad_sch, HE_Keyboard_Trial.kicad_pcb, HE_Keyboard_Trial.kicad_sch, sensor.kicad_sch]
2025-01-19 8th commit
    Some minor tweak
    [DB.kicad_sch, Dongle.kicad_sch, HE_Keyboard_Trial.kicad_pcb, MB.kicad_sch]
2025-01-19 9th commit
    minor tweak
    [HE_Keyboard_Trial.kicad_pcb, HE_Keyboard_Trial.kicad_sch]
2025-02-14 9th commit
    some minor tweak + adding production files
    [DB.kicad_sch, Dongle.kicad_sch, HE_Keyboard_Trial.kicad_pcb, MB.kicad_sch, bom backup.xlsx, bom.csv, bom.xlsx, bom_1.xlsx]
